Octopus343/OctoWatch/Banggood Clock Schematic.jpg

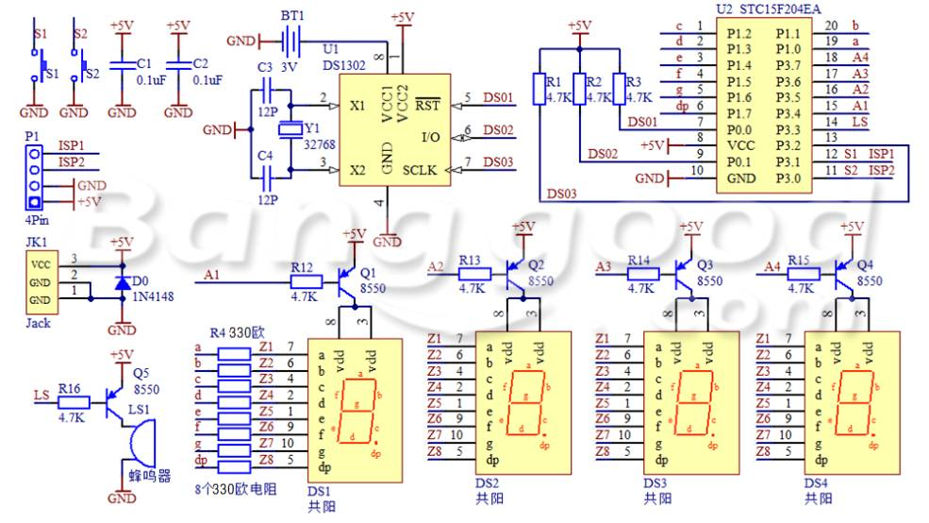
Banggood Clock Schematic.jpg
