Octopus343/OctoWatch/P32424234.jpg

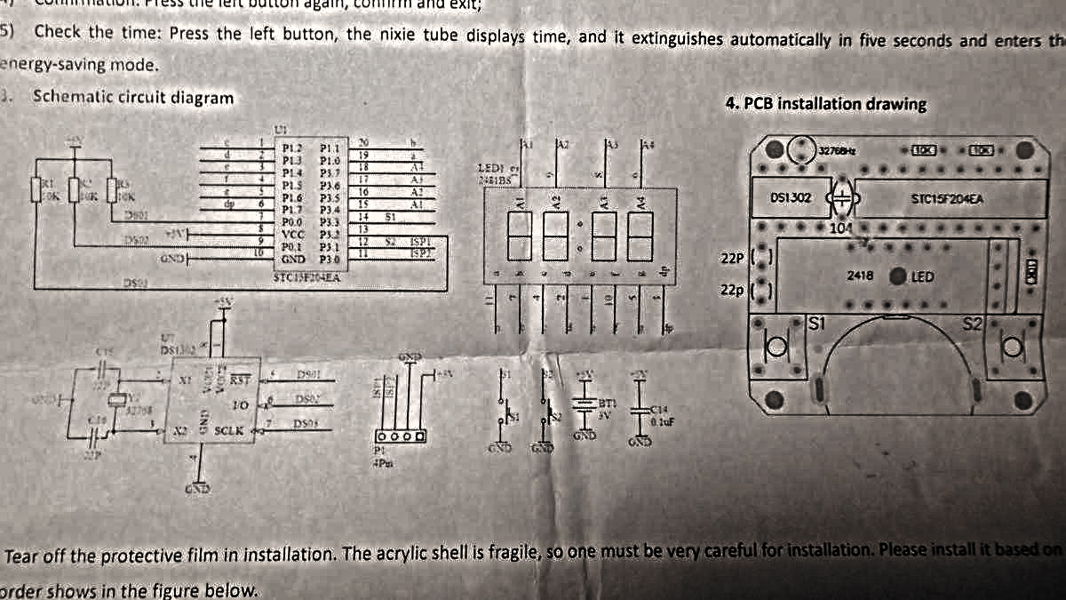
P32424234.jpg
