Octopus343/OctoWatch/PinOuts.txt

1------------GND         
2------------GND
3------------BL
4------------VCC
5------------GND
6------------RES
7------------DC
8------------SDA
9------------SCL
10-----------VCC
11-----------VCC
12-----------CS
13-----------GND
14-----------GND

1------------GND
2
3------------3V3
4------------3V3
5------------VCC
6------------BL
7------------RST
8------------CS
9------------SCLK
10-----------MOSI
11-----------GPIO27
12-----------GND
