Octopus343/OctoWatch/P3242423.jpg

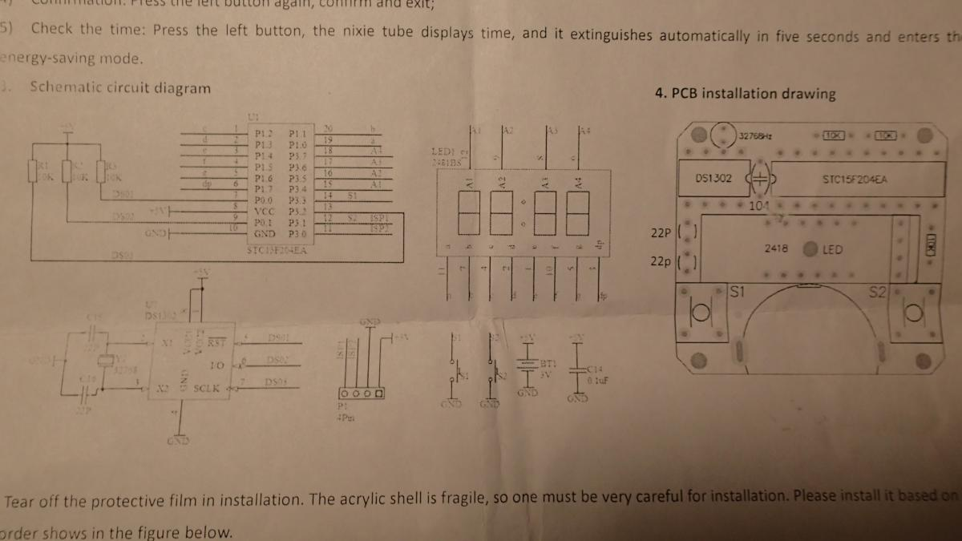
P3242423.jpg
