Octopus343/OctoWatch/SOLUTIONS/0-28-Inch-4-Digit-7-Segment-Display-GNS-2841Ax-Bx-.jpg

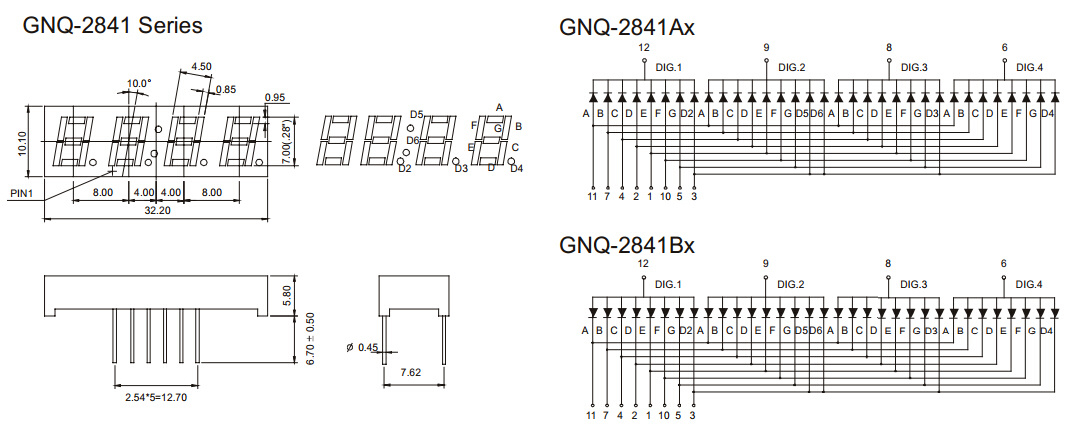
SOLUTIONS/0-28-Inch-4-Digit-7-Segment-Display-GNS-2841Ax-Bx-.jpg
