Octopus343/OctoWatch/SOLUTIONS/61j7WpCc-kL._SL1360_.jpg

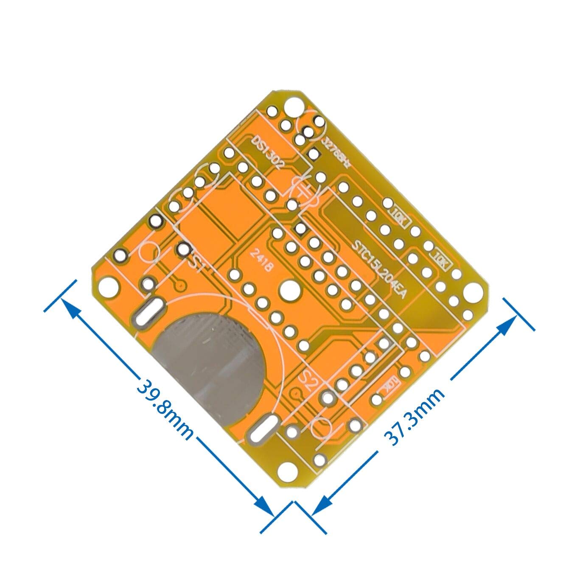
SOLUTIONS/61j7WpCc-kL._SL1360_.jpg
