Octopus343/OctoWatch/SOLUTIONS/61zpeQtWnJL._SL1360_.jpg

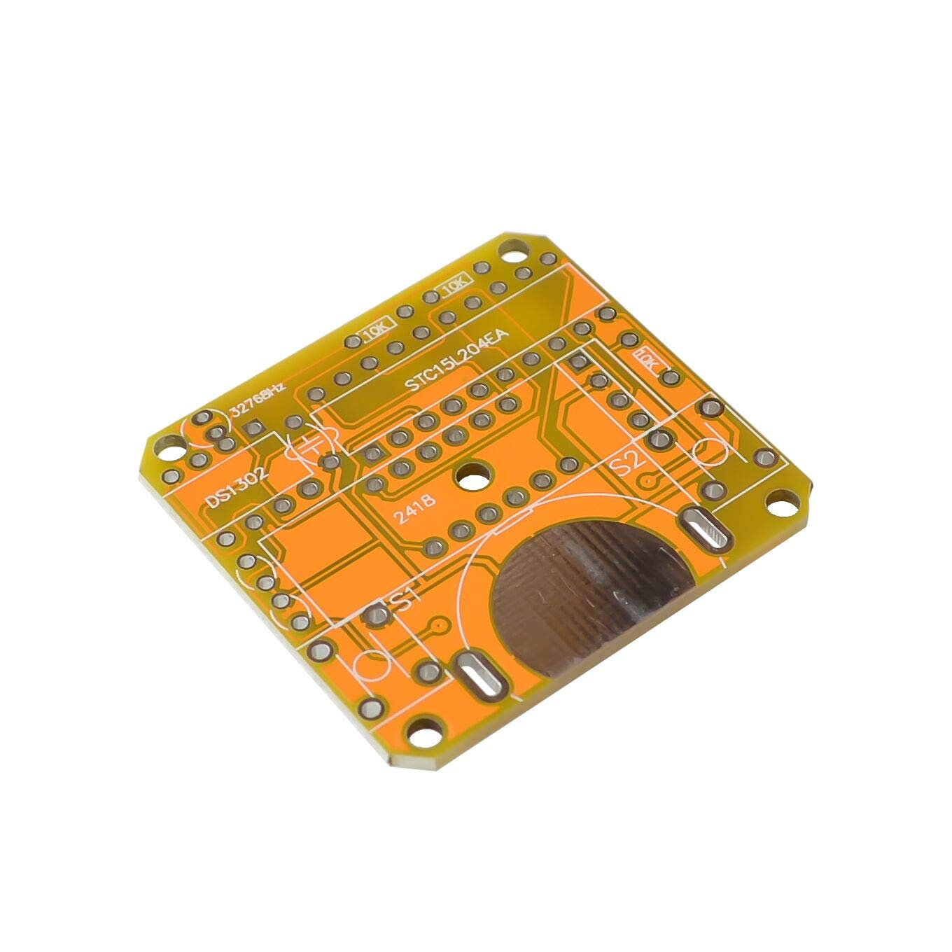
SOLUTIONS/61zpeQtWnJL._SL1360_.jpg
