Octopus343/OctoWatch/SOLUTIONS/scheme_v2.png

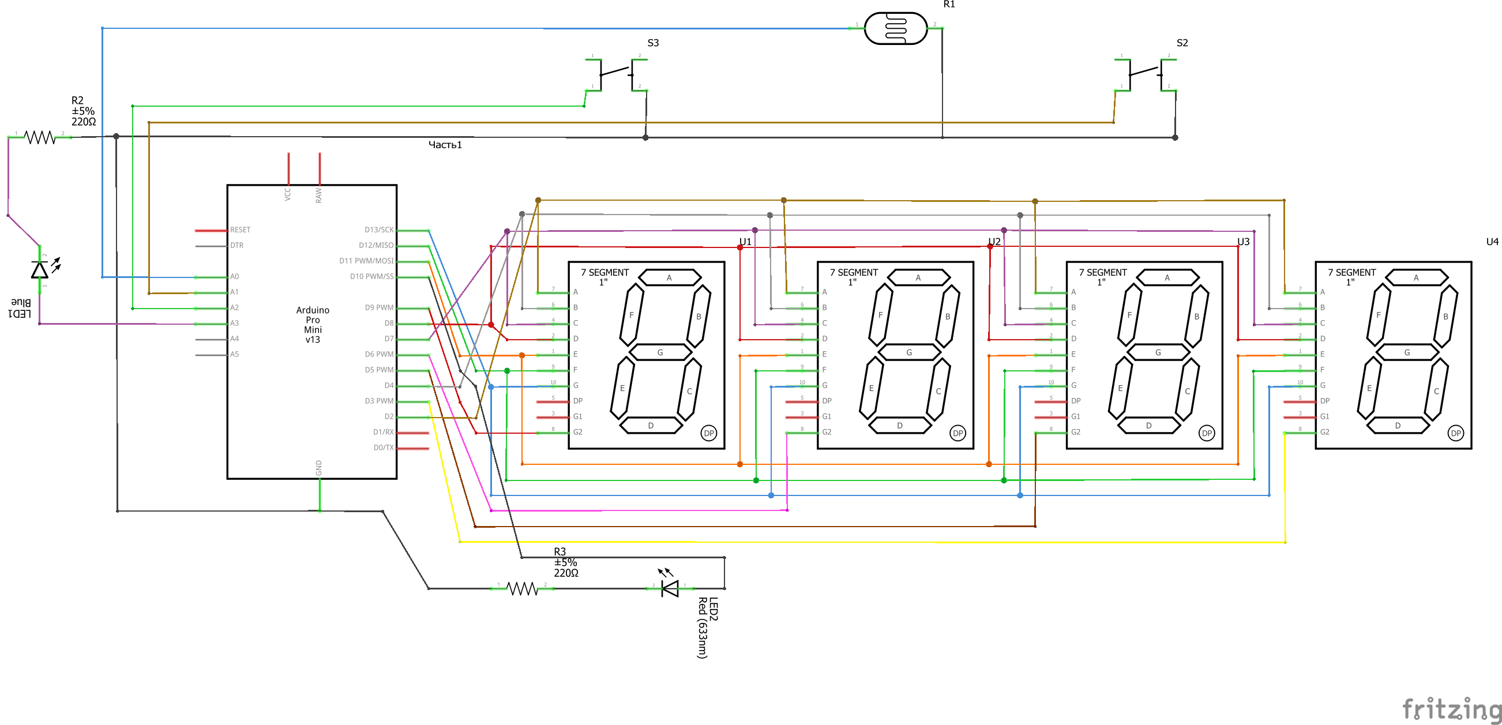
SOLUTIONS/scheme_v2.png
