Octopus343/OctoWatch/SOLUTIONS/tp4056-circuit.jpg

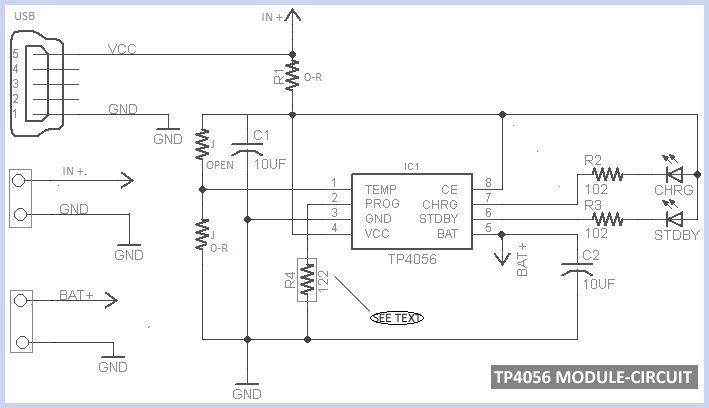
SOLUTIONS/tp4056-circuit.jpg
