Octopus343/OctoWatch/SOLUTIONS/Untitled-2.jpg

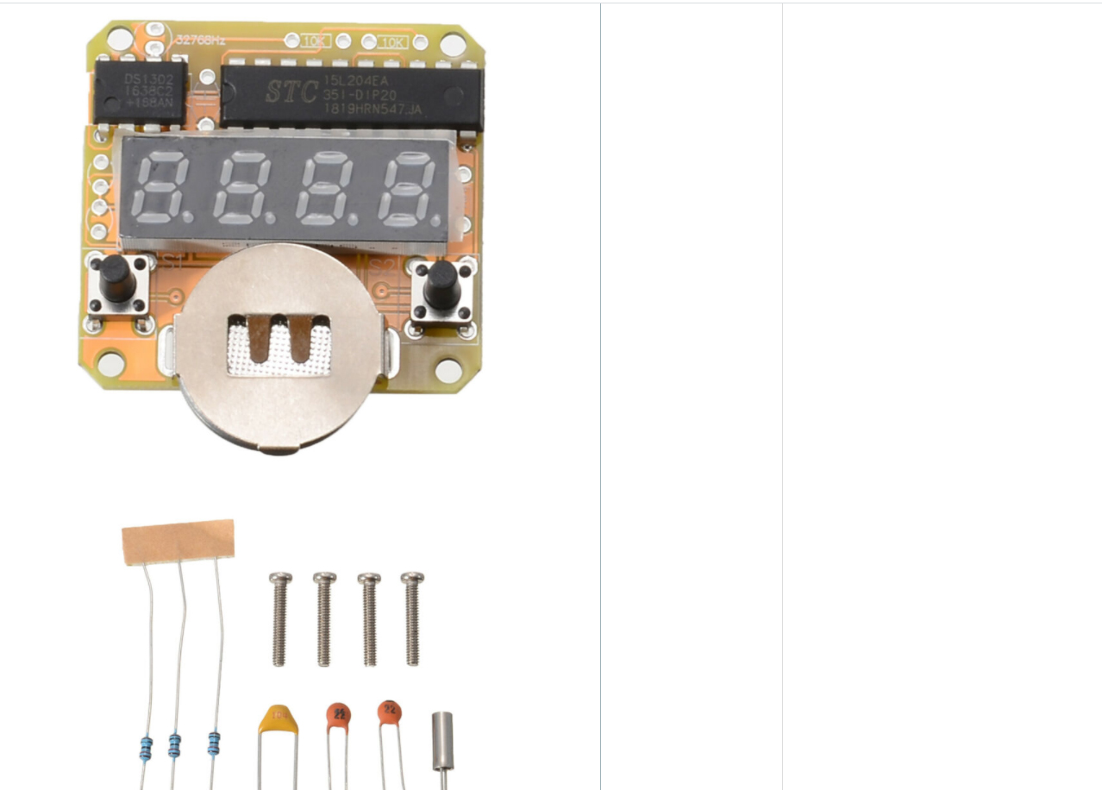
SOLUTIONS/Untitled-2.jpg
