Octopus343/OctoWatch/SOLUTIONS/Watch controller.jpg

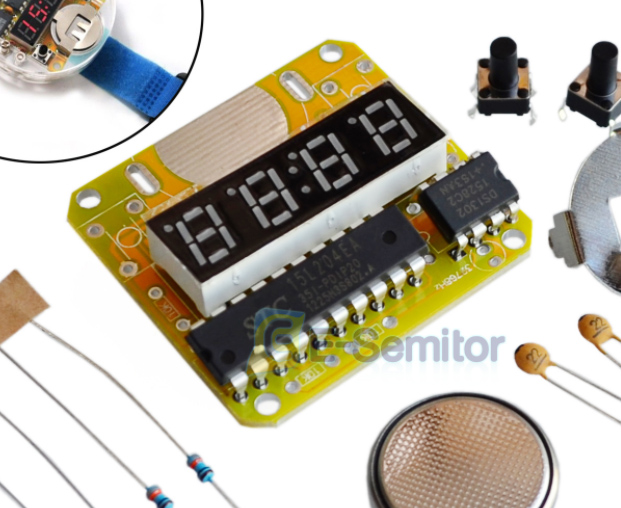
SOLUTIONS/Watch controller.jpg
