Octopus343/OctoWatch/SOLUTIONS/NeededMAterials.jpg

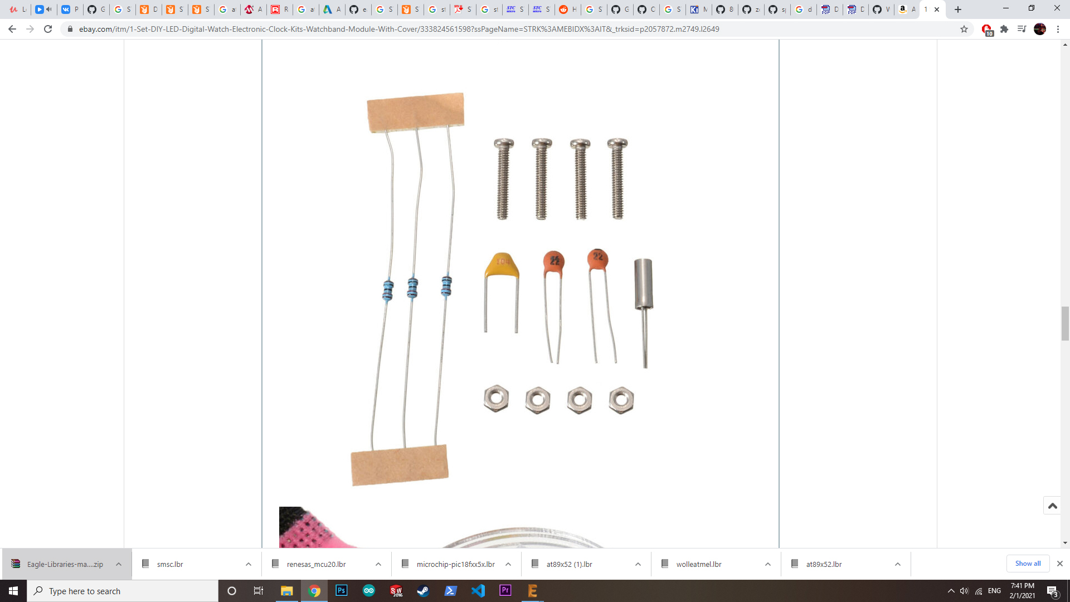
SOLUTIONS/NeededMAterials.jpg
