Octopus343/OctoWatch/3DPRINTER/WatchOcto4(24mm).SLDPRT

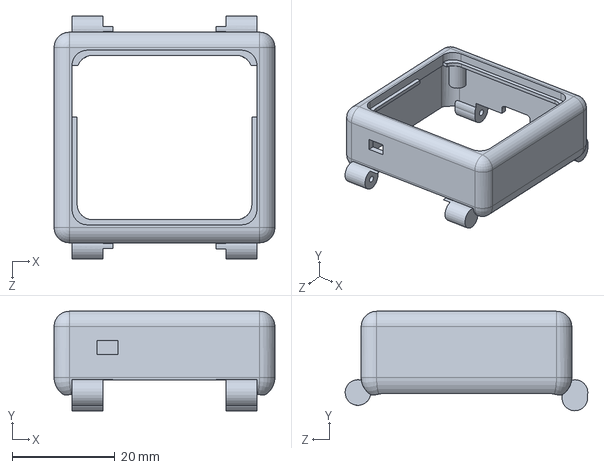
[picture p29: CAD file, 2021-01-08]
3DPRINTER/WatchOcto4(24mm).SLDPRT
43.0 x 19.4 x 47.2 mm
