Octopus343/OctoWatch/SOLUTIONS/timer_detector.obj

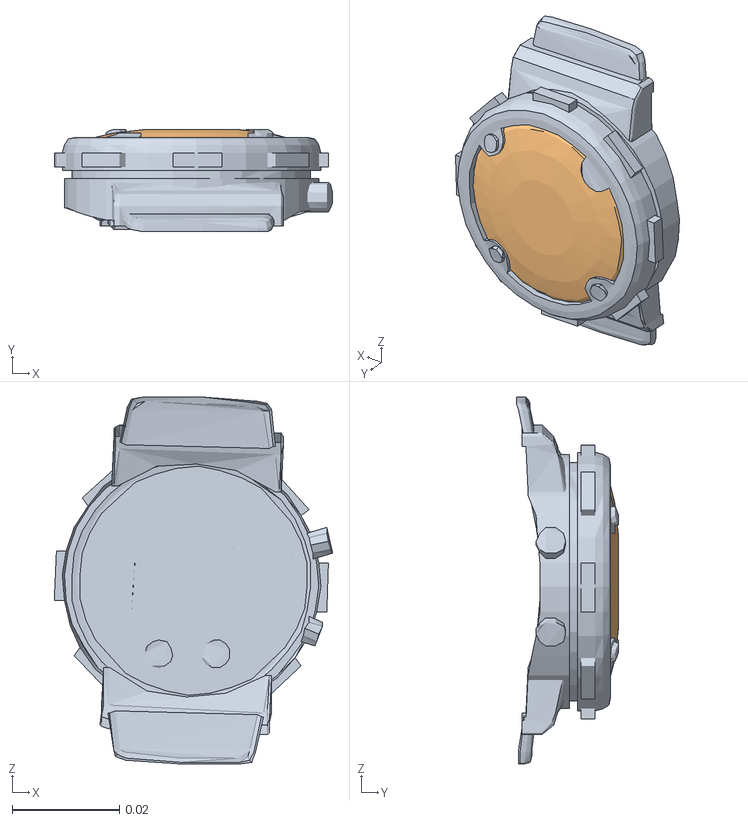
[picture p30: CAD file, 2021-02-23]
SOLUTIONS/timer_detector.obj
0.0519 x 0.0191 x 0.0684
wpn34_clock
wpn34_kollimator
