Octopus343/OctoWatch/3DPRINTER/WatchOcto4(22mm).SLDPRT

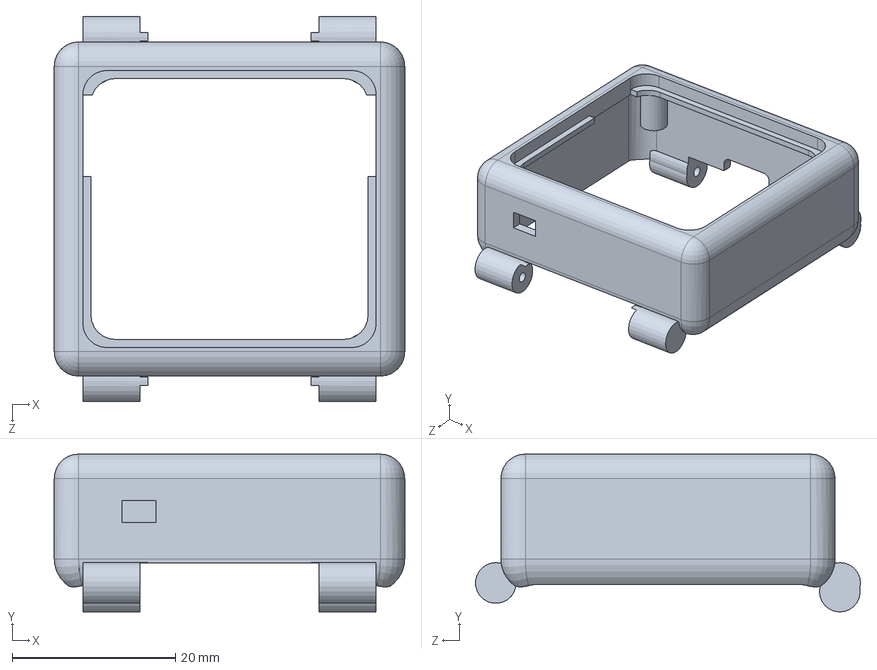
[picture p31: CAD file, 2021-01-08]
3DPRINTER/WatchOcto4(22mm).SLDPRT
43.0 x 19.4 x 47.2 mm
