Octopus343/OctoWatch/3DPRINTER/WatchOcto4Back.SLDPRT

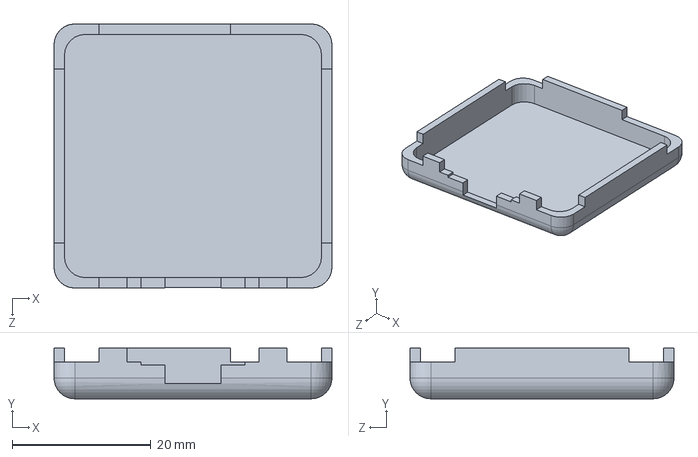
[picture p32: CAD file, 2021-01-08]
3DPRINTER/WatchOcto4Back.SLDPRT
40.0 x 7.29 x 38.0 mm
