Octopus343/OctoWatch/(list of files, cad)

Other CAD files:
3DPRINTER/WatchOcto4Top.SLDPRT
3DPRINTER/WatchOcto4(26mm).SLDPRT
3DPRINTER/WatchOcto4(22mm).STL
3DPRINTER/WatchOcto4(24mm).STL
3DPRINTER/WatchOcto4(26mm).STL
3DPRINTER/WatchOcto4Back.STL
3DPRINTER/WatchOcto4Top.DXF
