Octopus343/OctoWatch/SCHEME/OctoWatchSchemePackage1NoWire.brd

## EAGLE design SCHEME/OctoWatchSchemePackage1NoWire.brd (2021-07-11)

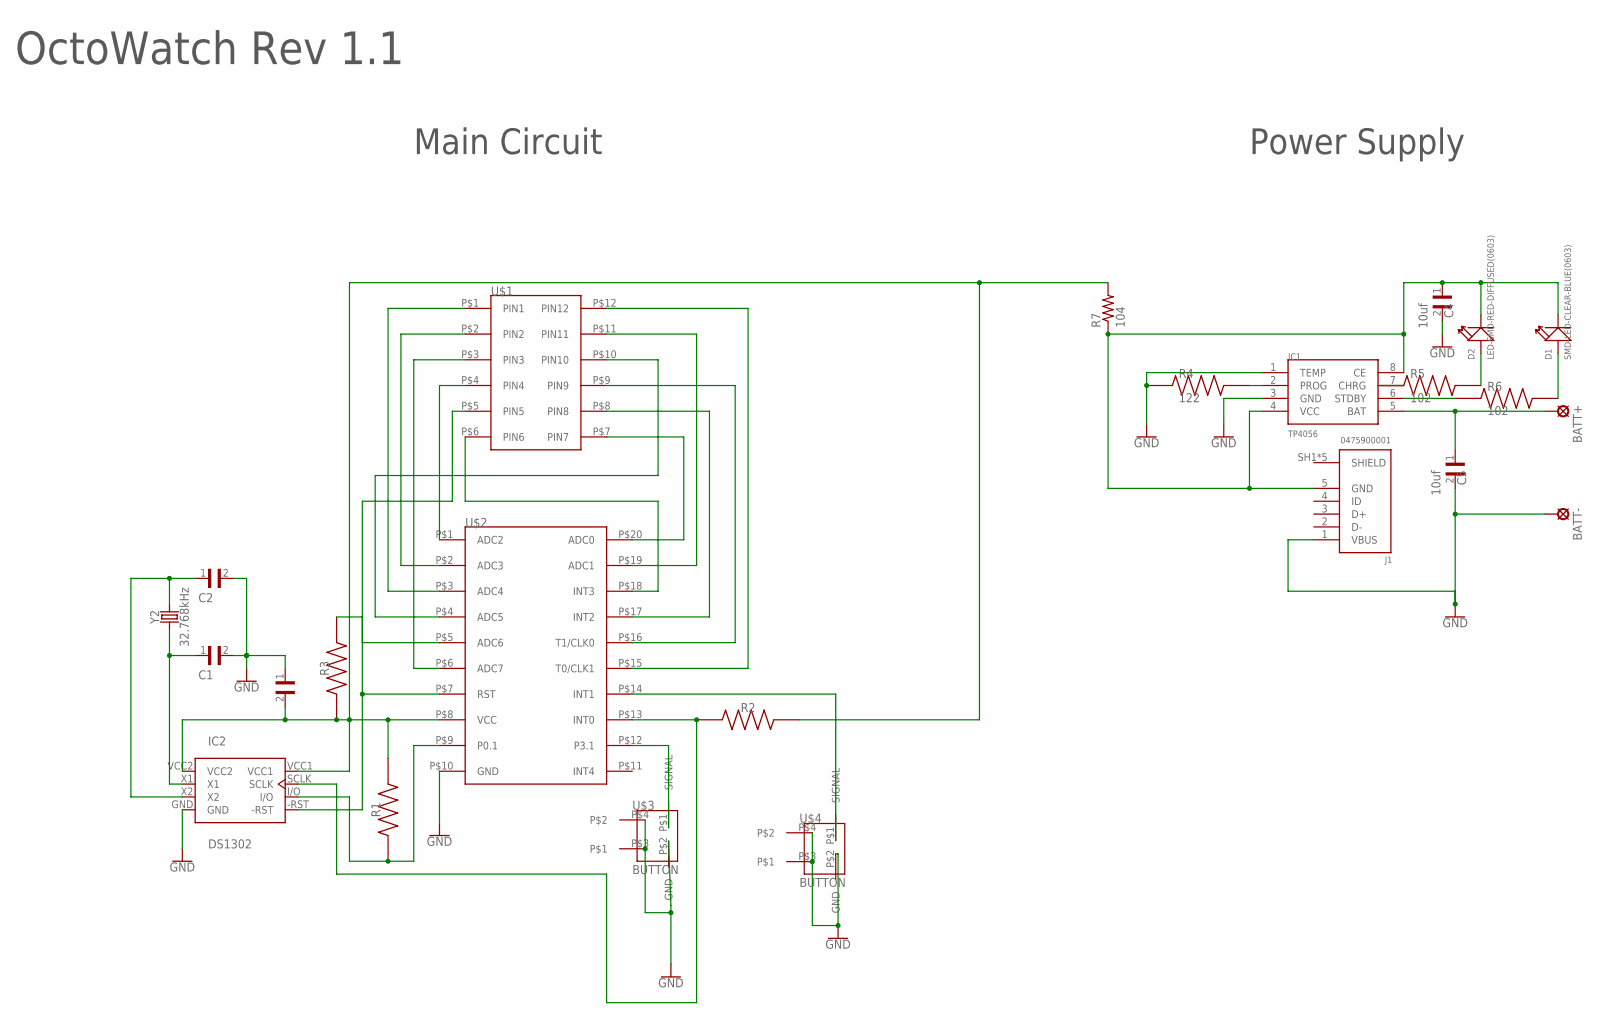
[picture p33: schematic OctoWatchSchemePackage1NoWire.sch]

Parts:
BATT+: LSP13
BATT-: LSP13
C1, C2: CL21C220JBANNNC; CAPC2012X140N
C3: CL21B104KCFNNNE; CAPC2012X140N
C4, C5: 10uf; CAPC1608X100N
D1: SMD-LED-CLEAR-BLUE(0603); LED-0603
D2: LED-SMD-RED-DIFFUSED(0603); LED-0603
IC1: TP4056; SOP-8
IC2: DS1302; DIL08
J1: 0475900001
R1, R2, R3: ERA3AEB103V; RES_ERA3AEB103V
R4: 122; RESC3116X65N
R5, R6: 102; RESC1608X55N
R7: 104; R0805
U$1: LED_SEGMENT
U$2: STC15F204AESTC15L204AE; STC15F204AE2
U$3, U$4: BUTTON
Y2: 32.768kHz; CRYSTAL-PTH-2X6-CYL

Connections:
BATT+: C3.2, IC2.VCC1, IC2.VCC2, R1.2, R2.2, R3.1, R7.2, U$2.P$8 (VCC)
GND: BATT-.MP, C1.2, C2.2, C3.1, C4.2, C5.2, IC1.1 (TEMP), IC1.3 (GND), IC2.GND, J1.1 (VBUS), R4.1, U$2.P$10 (GND), U$3.P$2 (GND), U$3.P$3, U$3.P$4, U$4.P$2 (GND), U$4.P$3, U$4.P$4
unnamed: U$1.P$1 (PIN1), U$2.P$3 (ADC4)
unnamed: U$1.P$2 (PIN2), U$2.P$2 (ADC3)
unnamed: U$1.P$4 (PIN4), U$2.P$1 (ADC2)
unnamed: U$1.P$3 (PIN3), U$2.P$6 (ADC7)
unnamed: U$1.P$5 (PIN5), U$2.P$5 (ADC6)
unnamed: U$1.P$6 (PIN6), U$2.P$18 (INT3)
unnamed: U$1.P$7 (PIN7), U$2.P$20 (ADC0)
unnamed: U$1.P$8 (PIN8), U$2.P$17 (INT2)
unnamed: U$1.P$9 (PIN9), U$2.P$16 (T1/CLK0)
unnamed: IC2.SCLK, R2.1, U$2.P$13 (INT0)
unnamed: IC2.-RST, R3.2, U$2.P$7 (RST)
unnamed: U$1.P$12 (PIN12), U$2.P$15 (T0/CLK1)
unnamed: C1.1, IC2.X1, Y2.1
unnamed: C4.1, D1.-, D2.-, IC1.4 (VCC), IC1.8 (CE), J1.5 (GND), R7.1
unnamed: C2.1, IC2.X2, Y2.2
unnamed: U$1.P$10 (PIN10), U$2.P$4 (ADC5)
unnamed: IC2.I/O, R1.1, U$2.P$9 (P0.1)
unnamed: BATT+.MP, C5.1, IC1.5 (BAT)
unnamed: U$2.P$14 (INT1), U$4.P$1 (SIGNAL)
unnamed: U$2.P$12 (P3.1), U$3.P$1 (SIGNAL)
unnamed: U$1.P$11 (PIN11), U$2.P$19 (ADC1)
unnamed: IC1.6 (STDBY), R6.1
unnamed: D1.+, R6.2
unnamed: IC1.7 (CHRG), R5.1
unnamed: D2.+, R5.2
unnamed: IC1.2 (PROG), R4.2
SHIELD: J1.SH1 (SHIELD), J1.SH2 (SHIELD), J1.SH3 (SHIELD), J1.SH4 (SHIELD), J1.SH5 (SHIELD)

Notes on the sheet:
OctoWatch Rev 1.1
Main Circuit
Power Supply

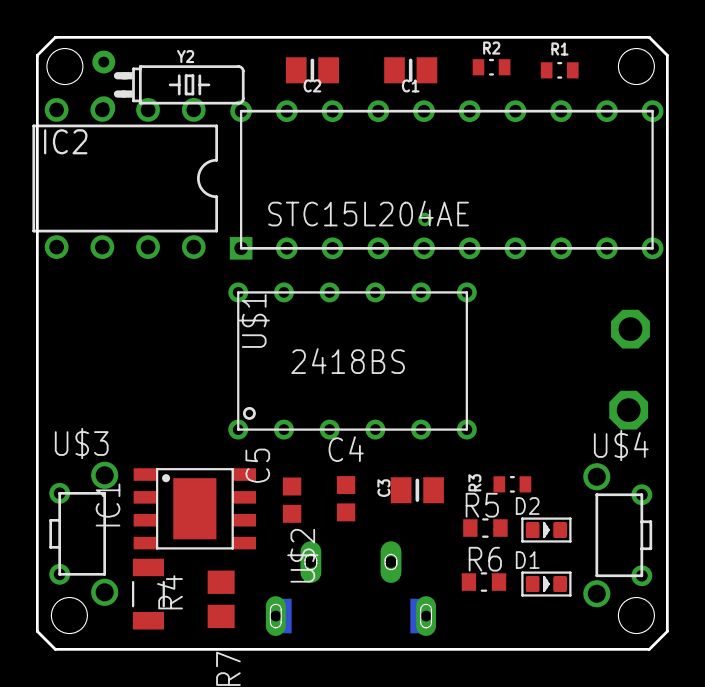
[picture p34: board OctoWatchSchemePackage1NoWire.brd from above]

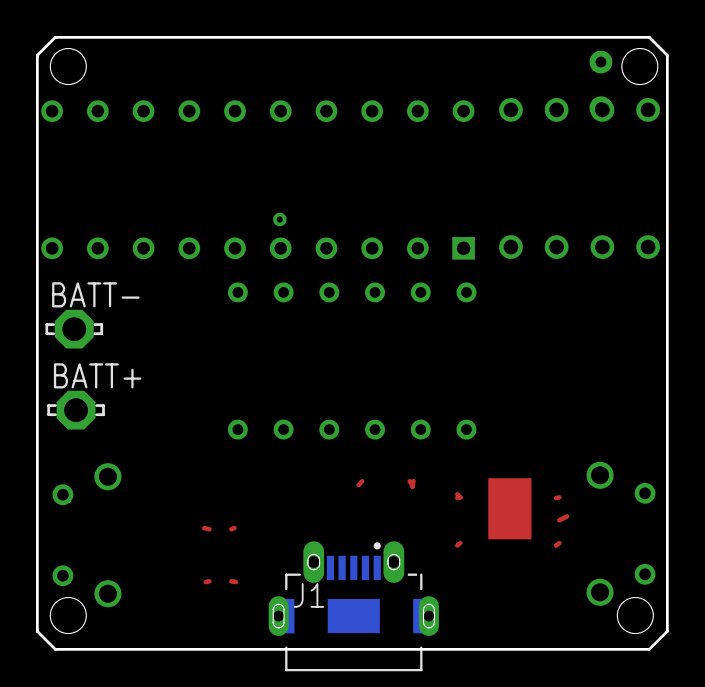
[picture p35: board OctoWatchSchemePackage1NoWire.brd from below]

Board: 2 copper layers, 35.0 x 34.0 mm, 24 parts (3 on the bottom side), 29 nets.
