Octopus343/OctoWatch/(commit log)

2021-01-08 Nixie Watch Project
    [WatchOcto4(22mm).SLDPRT, WatchOcto4(22mm).STL, WatchOcto4(24mm).SLDPRT, WatchOcto4(24mm).STL, WatchOcto4(26mm).SLDPRT, WatchOcto4(26mm).STL, WatchOcto4Back.SLDPRT, WatchOcto4Back.STL]
2021-02-23 Pushing SchemeFile
    [OctoWatchScheme.brd, OctoWatchScheme.sch, WatchOcto4(22mm).SLDPRT, WatchOcto4(22mm).STL, WatchOcto4(24mm).SLDPRT, WatchOcto4(24mm).STL, WatchOcto4(26mm).SLDPRT, WatchOcto4(26mm).STL]
2021-02-23 Pushing Scheme
    [OctoWatchScheme.brd]
2021-02-23 Finalazing scheme
    [OctoWatchScheme.brd, OctoWatchScheme.sch]
2021-02-24 silking changed
    [OctoWatchScheme.brd]
2021-02-24 GerBer Added
    [OctoWatchScheme.brd, OctoWatchScheme.sch]
2021-03-22 adding 2nd ver
    [OctoWatchScheme2.brd, OctoWatchScheme2.sch]
2021-04-13 Adding new package
    [OctoWatchScheme.brd, OctoWatchScheme.sch]
