Octopus343/OctoWatch/(notices)

Notices in the files:
SOLUTIONS/timer_detector.obj:
3ds Max Wavefront OBJ Exporter v0.97b - (c)2007 guruware
parts and their libraries:
SparkFun-Clocks: Licensing: Creative Commons ShareAlike 4.0 International - https://creativecommons.org/licenses/by-sa/4.0
